EmpiricalEE/blues_note-hardware/Reference_Designs/SingleDryCell-LR6|AA/SingleDryCell_RevB.pdf

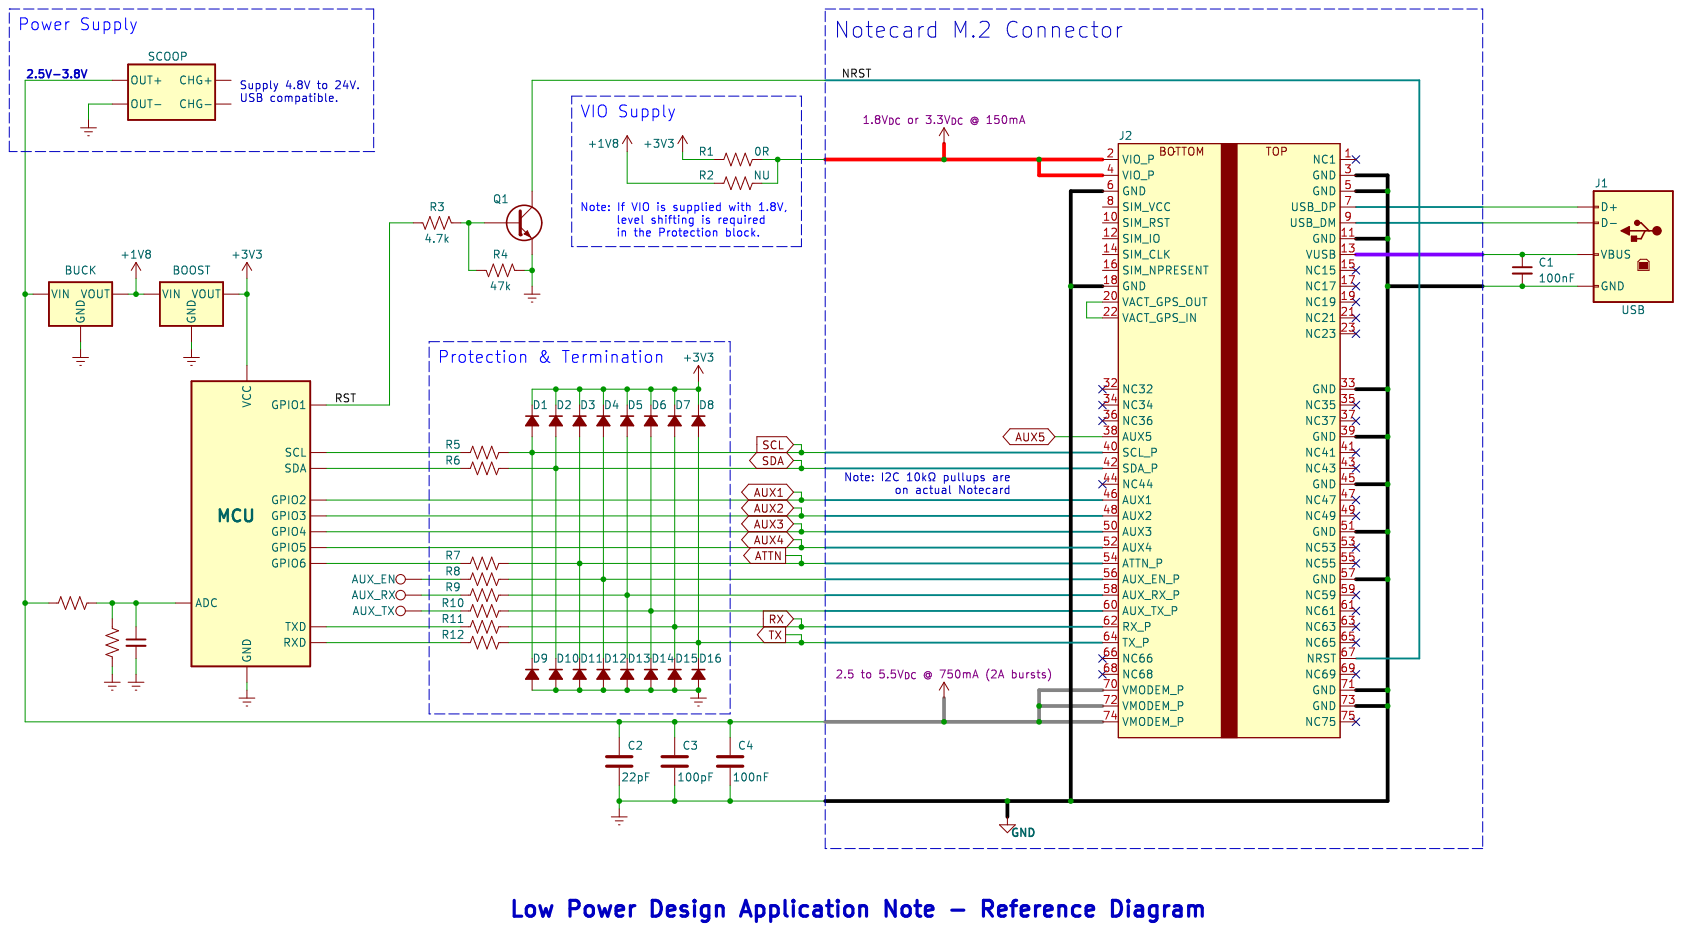
[picture p1: page 1]
