EmpiricalEE/blues_note-hardware/Reference_Designs/SingleDryCell-LR6|AA/SingleDryCell_RevA.pdf

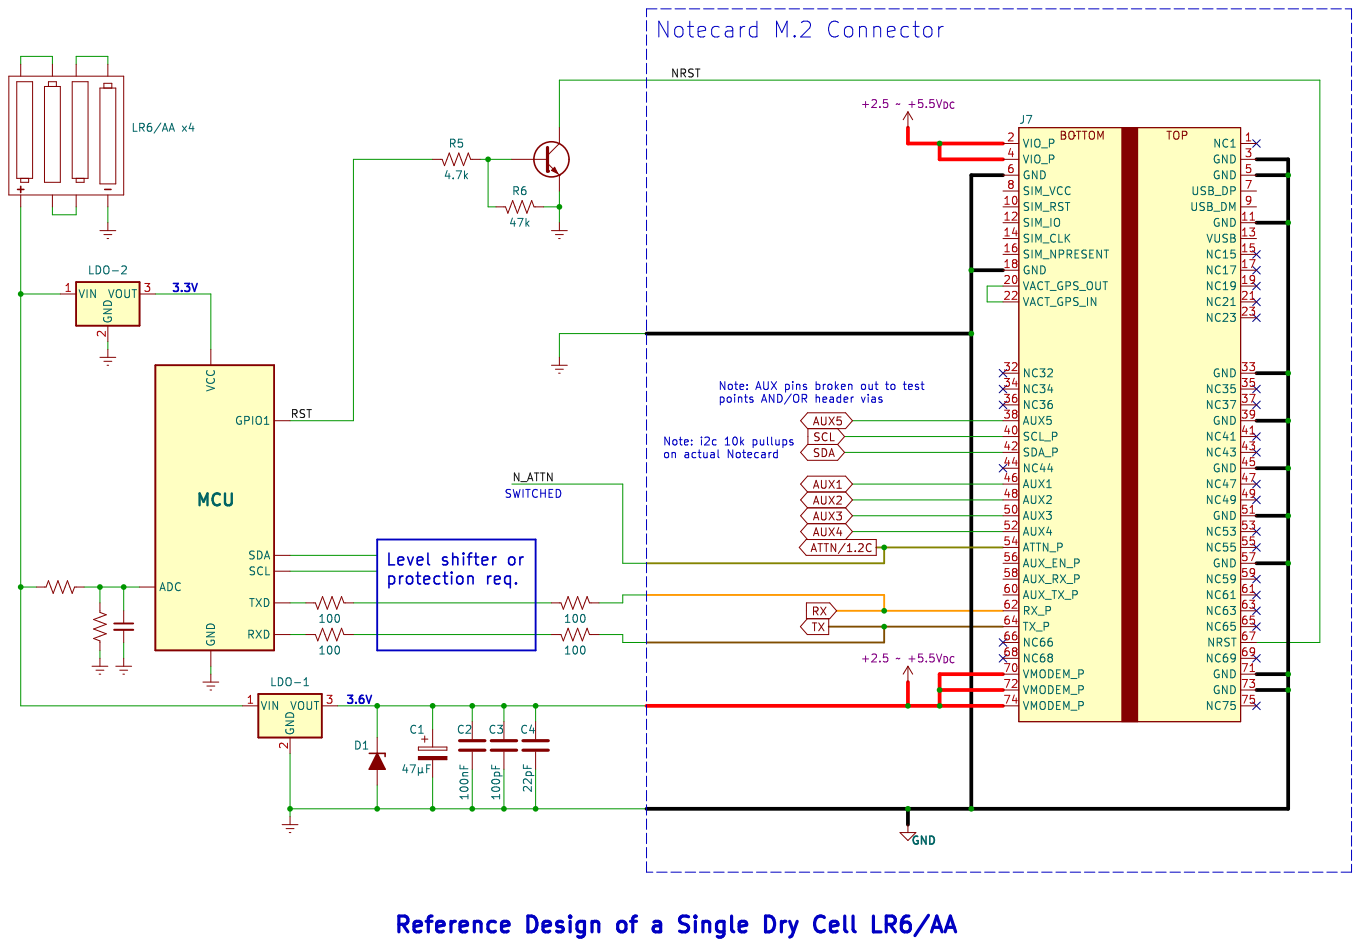
[picture p2: page 1]
