EmpiricalEE/blues_note-hardware/Notecarrier-B/KiCad_format/Notecarrier-B.kicad_sch

## KiCad design Notecarrier-B/KiCad_format/Notecarrier-B.kicad_sch (2023-07-28)

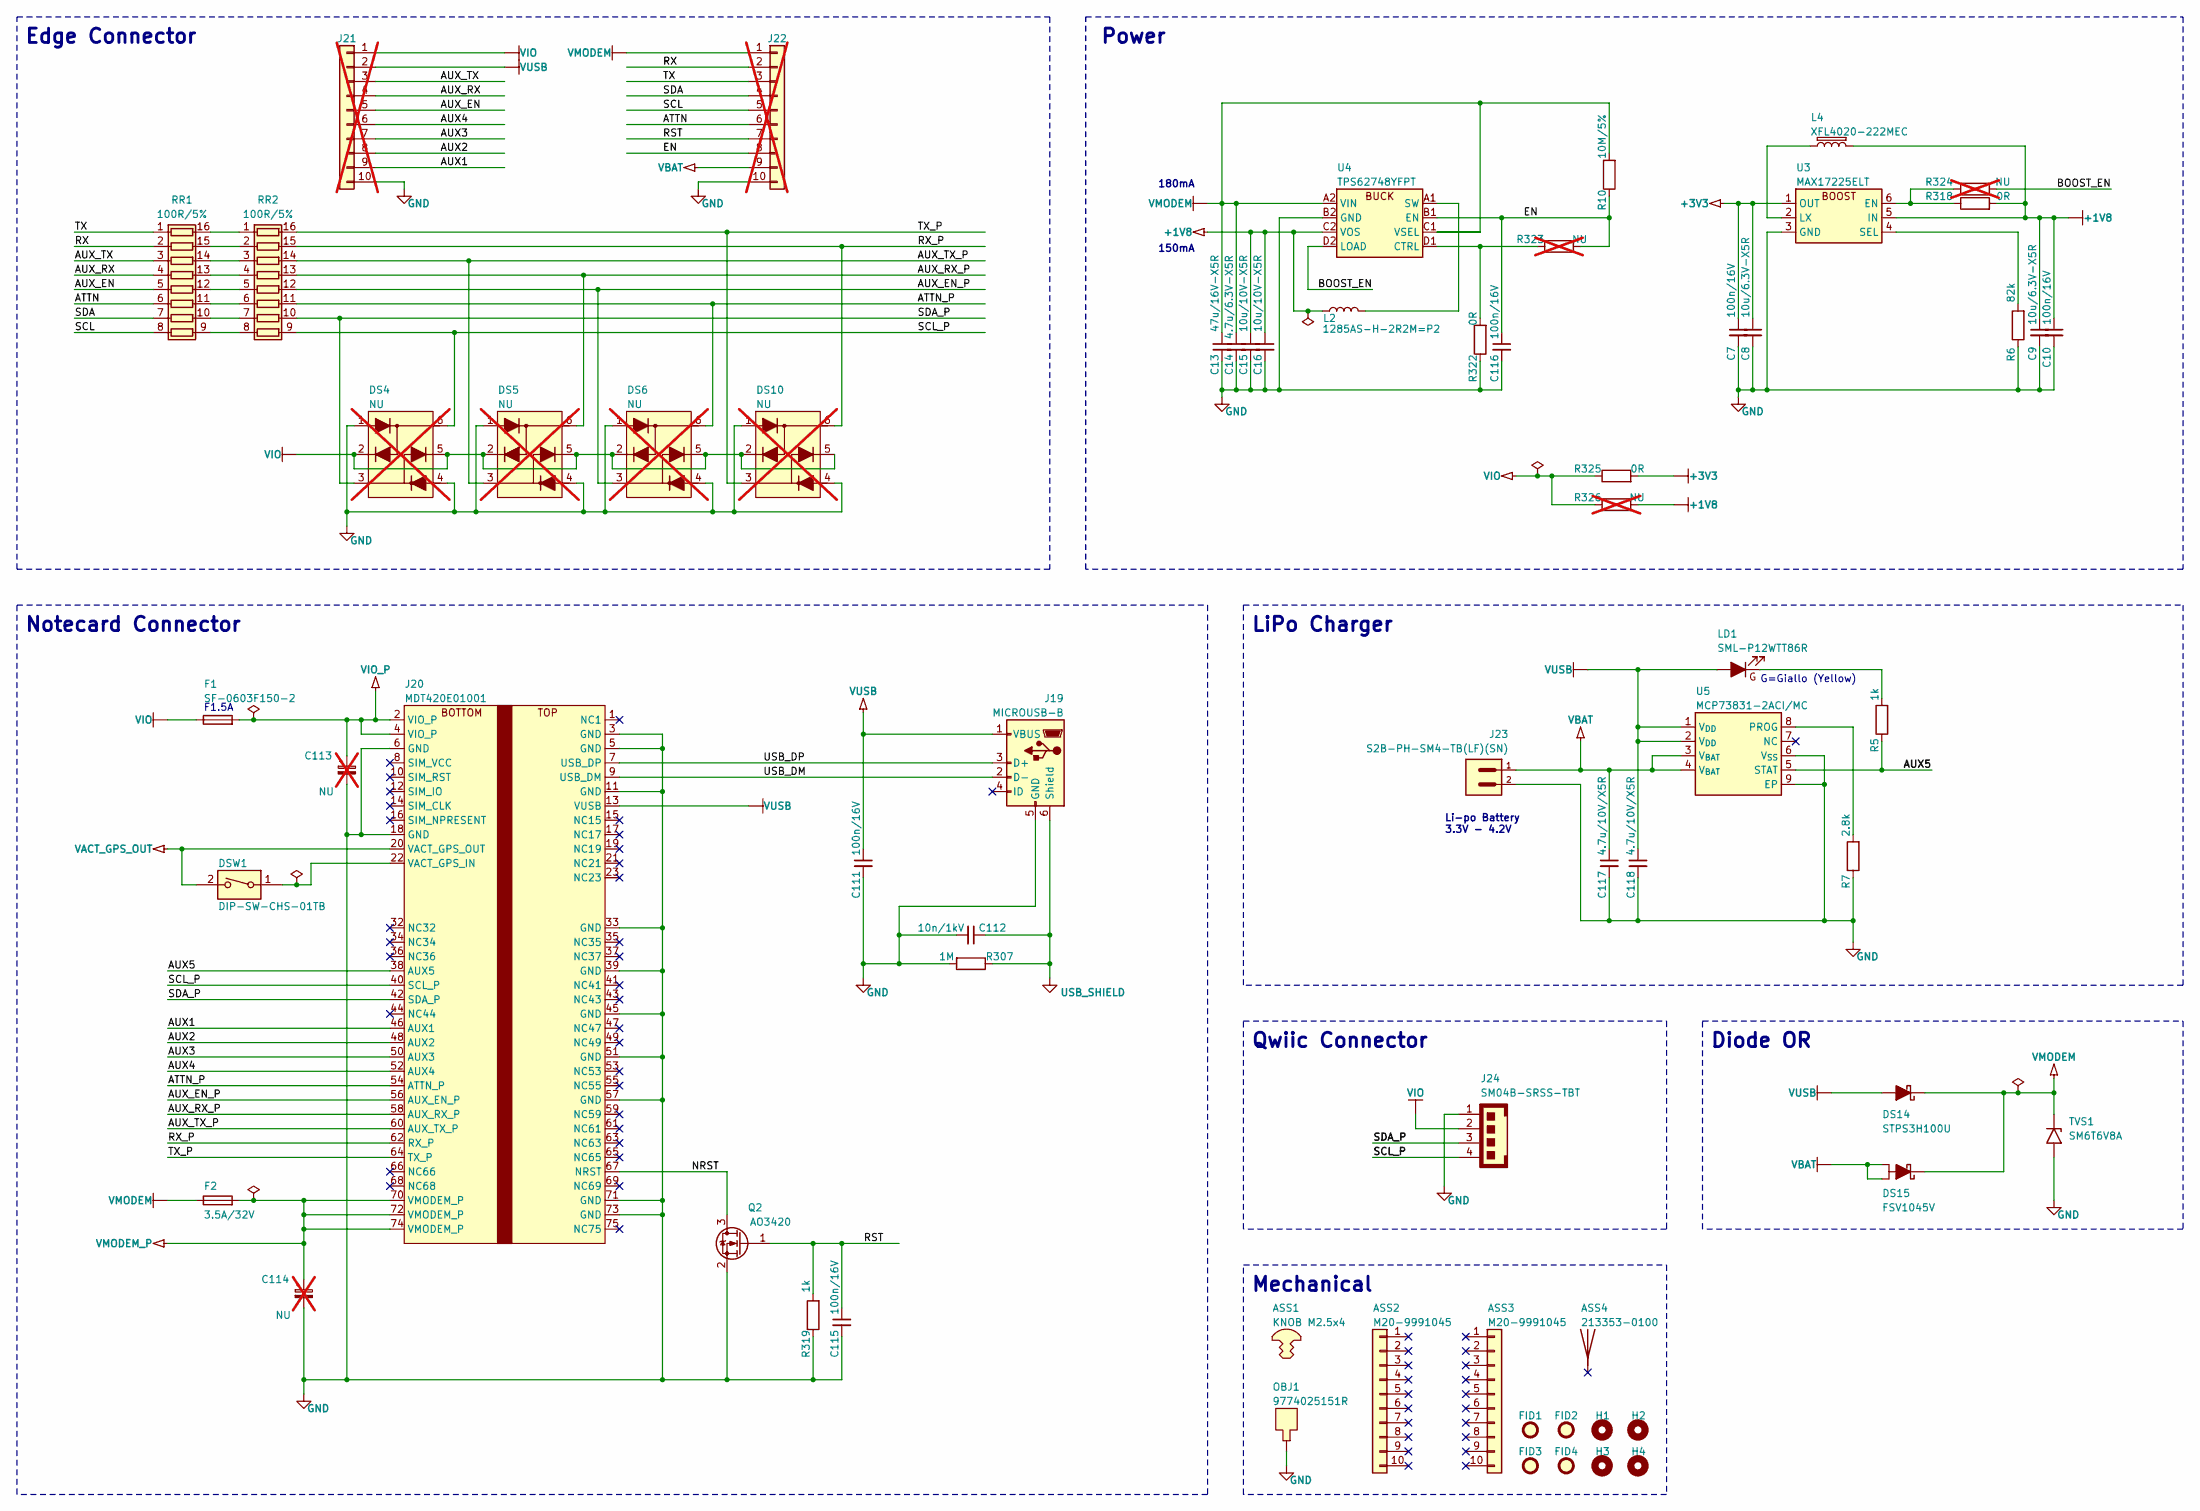
[picture p3: schematic Notecarrier-B.kicad_sch]

Parts:
ASS1: KNOB M2.5x4
ASS2, ASS3: M20-9991045; MPN M20-9991045
ASS4: 213353-0100; MPN 213353-0100
C7, C10, C111, C115, C116: 100n/16V; CS-C-0402_NO-FILL
C8, C9: 10u/6.3V-X5R; CS-C-0402_NO-FILL
C13: 47u/16V-X5R; CS-C-1206
C14: 4.7u/6.3V-X5R; CS-C-0402_NO-FILL
C15, C16: 10u/10V-X5R; CS-C-0603
C112: 10n/1kV; CS-C-1206
C113: NU; CS-T-A; MPN F930J107KAA; not fitted
C114: NU; CS-T-B; MPN F930J227KBA; not fitted
C117, C118: 4.7u/10V/X5R; CS-C-0603; MPN CL10A475KP8NNNC
DS4, DS5, DS6, DS10: NU; SOT563; MPN BAV99BRVA-7; not fitted
DS14: STPS3H100U; SMB; MPN STPS3H100U
DS15: FSV1045V; TO277-3; MPN FSV1045V
DSW1: DIP-SW-CHS-01TB; DSS-CHS-01TB
F1: SF-0603F150-2; FS-0603; MPN SF-0603F150-2
F2: 3.5A/32V; FS-0603; MPN 0603SFV350F/32-2
FID1, FID2, FID3, FID4: TPS; FIDUCIAL
H1, H2, H3, H4: MountingHole; FORO-0330-U
J19: MICROUSB-B; J-5-0065-FOS-MICROUSB10118192; MPN 10118192-0001LF
J20: MDT420E01001; J-75-0050-MOS-M2-E
J21, J22: NU; J-10-0254-MDT; MPN M20-9991045; not fitted
J23: S2B-PH-SM4-TB(LF)(SN); J-2-0200-MOS-S2B; MPN S2B-PH-SM4-TB(LF)(SN)
J24: SM04B-SRSS-TBT; J-4-0100-MOS-SH; MPN SM04B-SRSS-TBT(LF)(SN)
L2: 1285AS-H-2R2M=P2; LS-0806; MPN 1285AS-H-2R2M=P2
L4: XFL4020-222MEC; LS-XFL4020; MPN XFL4020-222MEC
LD1: SML-P12WTT86R; LD-0402; MPN SML-P12WTT86R
OBJ1: 9774025151R; DIST-WASMSIM0250
Q2: AO3420; SOT23_NO-FILL
R5: 1k; RS-0201_NO-FILL; MPN CRCW02011K00FNED
R6: 82k; RS-0402_NO-FILL
R7: 2.8k; RS-0201_NO-FILL; MPN CRCW02012K80FKED
R10: 10M/5%; RS-0402_NO-FILL
R307: 1M; RS-1206
R318, R322, R325: 0R; RS-0402_NO-FILL
R319: 1k; RS-0402_NO-FILL
R323, R324, R326: NU; RS-0402_NO-FILL; not fitted
RR1, RR2: 100R/5%; RR-8X-1506
TVS1: SM6T6V8A; SMB
U3: MAX17225ELT; WDFN6-0200X0200; MPN MAX17225ELT+T
U4: TPS62748YFPT; XFBGA8; MPN TPS62748YFPT
U5: MCP73831-2ACI/MC; VFDFN8-EXP; MPN MCP73831-2ACI/MC

Connections:
+1V8: C9.1, C10.1, C15.1, C16.1, L2.2, L4.2, R318.2, R326.2, U3.5 (IN), U4.C2 (VOS)
+3V3: C7.1, C8.1, R325.2, U3.1 (OUT)
ATTN: J22.6, RR1.6 (R6.1)
ATTN_P: DS6.6 (K1A2), J20.54 (ATTN_P), RR2.11 (R6.2)
AUX1: J20.46 (AUX1), J21.9
AUX2: J20.48 (AUX2), J21.8
AUX3: J20.50 (AUX3), J21.7
AUX4: J20.52 (AUX4), J21.6
AUX5: J20.38 (AUX5), R5.1, U5.5 (STAT)
AUX_EN: J21.5, RR1.5 (R5.1)
AUX_EN_P: DS6.3 (K3A4), J20.56 (AUX_EN_P), RR2.12 (R5.2)
AUX_RX: J21.4, RR1.4 (R4.1)
AUX_RX_P: DS5.6 (K1A2), J20.58 (AUX_RX_P), RR2.13 (R4.2)
AUX_TX: J21.3, RR1.3 (R3.1)
AUX_TX_P: DS5.3 (K3A4), J20.60 (AUX_TX_P), RR2.14 (R3.2)
BOOST_EN: R324.2, U4.D2 (LOAD)
EN: C116.1, J22.8, R10.1, R323.2, U4.B1 (EN)
GND: C7.2, C8.2, C9.2, C10.2, C13.2, C14.2, C15.2, C16.2, C111.2, C112.2, C113.2, C114.2, C115.2, C116.2, C117.2, C118.2, DS4.1 (A1), DS4.4 (A3), DS5.1 (A1), DS5.4 (A3), DS6.1 (A1), DS6.4 (A3), DS10.1 (A1), DS10.4 (A3), J19.5 (GND), J20.3 (GND), J20.5 (GND), J20.6 (GND), J20.11 (GND), J20.18 (GND), J20.33 (GND), J20.39 (GND), J20.45 (GND), J20.51 (GND), J20.57 (GND), J20.71 (GND), J20.73 (GND), J21.10, J22.10, J23.2, J24.1, OBJ1.1, Q2.2 (S), R6.1, R7.1, R307.2, R319.1, R322.1, TVS1.2 (A2), U3.3 (GND), U4.B2 (GND), U5.6 (V_{SS}), U5.9 (EP)
NRST: J20.67 (NRST), Q2.3 (D)
unnamed: DSW1.1, J20.22 (VACT_GPS_IN)
unnamed: L2.1, U4.A1 (SW)
unnamed: L4.1, U3.2 (LX)
unnamed: LD1.1 (K), R5.2
unnamed: R6.2, U3.4 (SEL)
unnamed: R7.2, U5.8 (PROG)
unnamed: R318.1, R324.1, U3.6 (EN)
unnamed: R322.2, R323.1, U4.D1 (CTRL)
unnamed: RR1.9 (R8.2), RR2.8 (R8.1)
unnamed: RR1.10 (R7.2), RR2.7 (R7.1)
unnamed: RR1.11 (R6.2), RR2.6 (R6.1)
unnamed: RR1.12 (R5.2), RR2.5 (R5.1)
unnamed: RR1.13 (R4.2), RR2.4 (R4.1)
unnamed: RR1.14 (R3.2), RR2.3 (R3.1)
unnamed: RR1.15 (R2.2), RR2.2 (R2.1)
unnamed: RR1.16 (R1.2), RR2.1 (R1.1)
RST: C115.1, J22.7, Q2.1 (G), R319.2
RX: J22.2, RR1.2 (R2.1)
RX_P: DS10.6 (K1A2), J20.62 (RX_P), RR2.15 (R2.2)
SCL: J22.5, RR1.8 (R8.1)
SCL_P: DS4.6 (K1A2), J20.40 (SCL_P), J24.4, RR2.9 (R8.2)
SDA: J22.4, RR1.7 (R7.1)
SDA_P: DS4.3 (K3A4), J20.42 (SDA_P), J24.3, RR2.10 (R7.2)
TX: J22.3, RR1.1 (R1.1)
TX_P: DS10.3 (K3A4), J20.64 (TX_P), RR2.16 (R1.2)
USB_DM: J19.2 (D-), J20.9 (USB_DM)
USB_DP: J19.3 (D+), J20.7 (USB_DP)
USB_SHIELD: C112.1, J19.6 (Shield), R307.1
VACT_GPS_OUT: DSW1.2, J20.20 (VACT_GPS_OUT)
VBAT: C117.1, DS15.1 (A1), DS15.2 (A2), J22.9, J23.1, U5.3 (V_{BAT}), U5.4 (V_{BAT})
VIO: DS4.2 (K2), DS4.5 (K4), DS5.2 (K2), DS5.5 (K4), DS6.2 (K2), DS6.5 (K4), DS10.2 (K2), DS10.5 (K4), F1.1, J21.1, J24.2, R325.1, R326.1
VIO_P: C113.1, F1.2, J20.2 (VIO_P), J20.4 (VIO_P)
VMODEM: C13.1, C14.1, DS14.1 (K), DS15.3 (C), F2.1, J22.1, R10.2, TVS1.1 (A1), U4.A2 (VIN), U4.C1 (VSEL)
VMODEM_P: C114.1, F2.2, J20.70 (VMODEM_P), J20.72 (VMODEM_P), J20.74 (VMODEM_P)
VUSB: C111.1, C118.1, DS14.2 (A), J19.1 (VBUS), J20.13 (VUSB), J21.2, LD1.2 (A), U5.1 (V_{DD}), U5.2 (V_{DD})

Notes on the sheet:
LiPo Charger
Mechanical
G=Giallo (Yellow)
Qwiic Connector
150mA
180mA
Li-po Battery 3.3V - 4.2V
F1.5A
Edge Connector
Notecard Connector
Power
Diode OR
