EmpiricalEE/blues_note-hardware/Reference_Designs/SingleDryCell-LR6|AA/SingleDryCell.kicad_sch

## KiCad design Reference_Designs/SingleDryCell-LR6|AA/SingleDryCell.kicad_sch (2023-08-22)

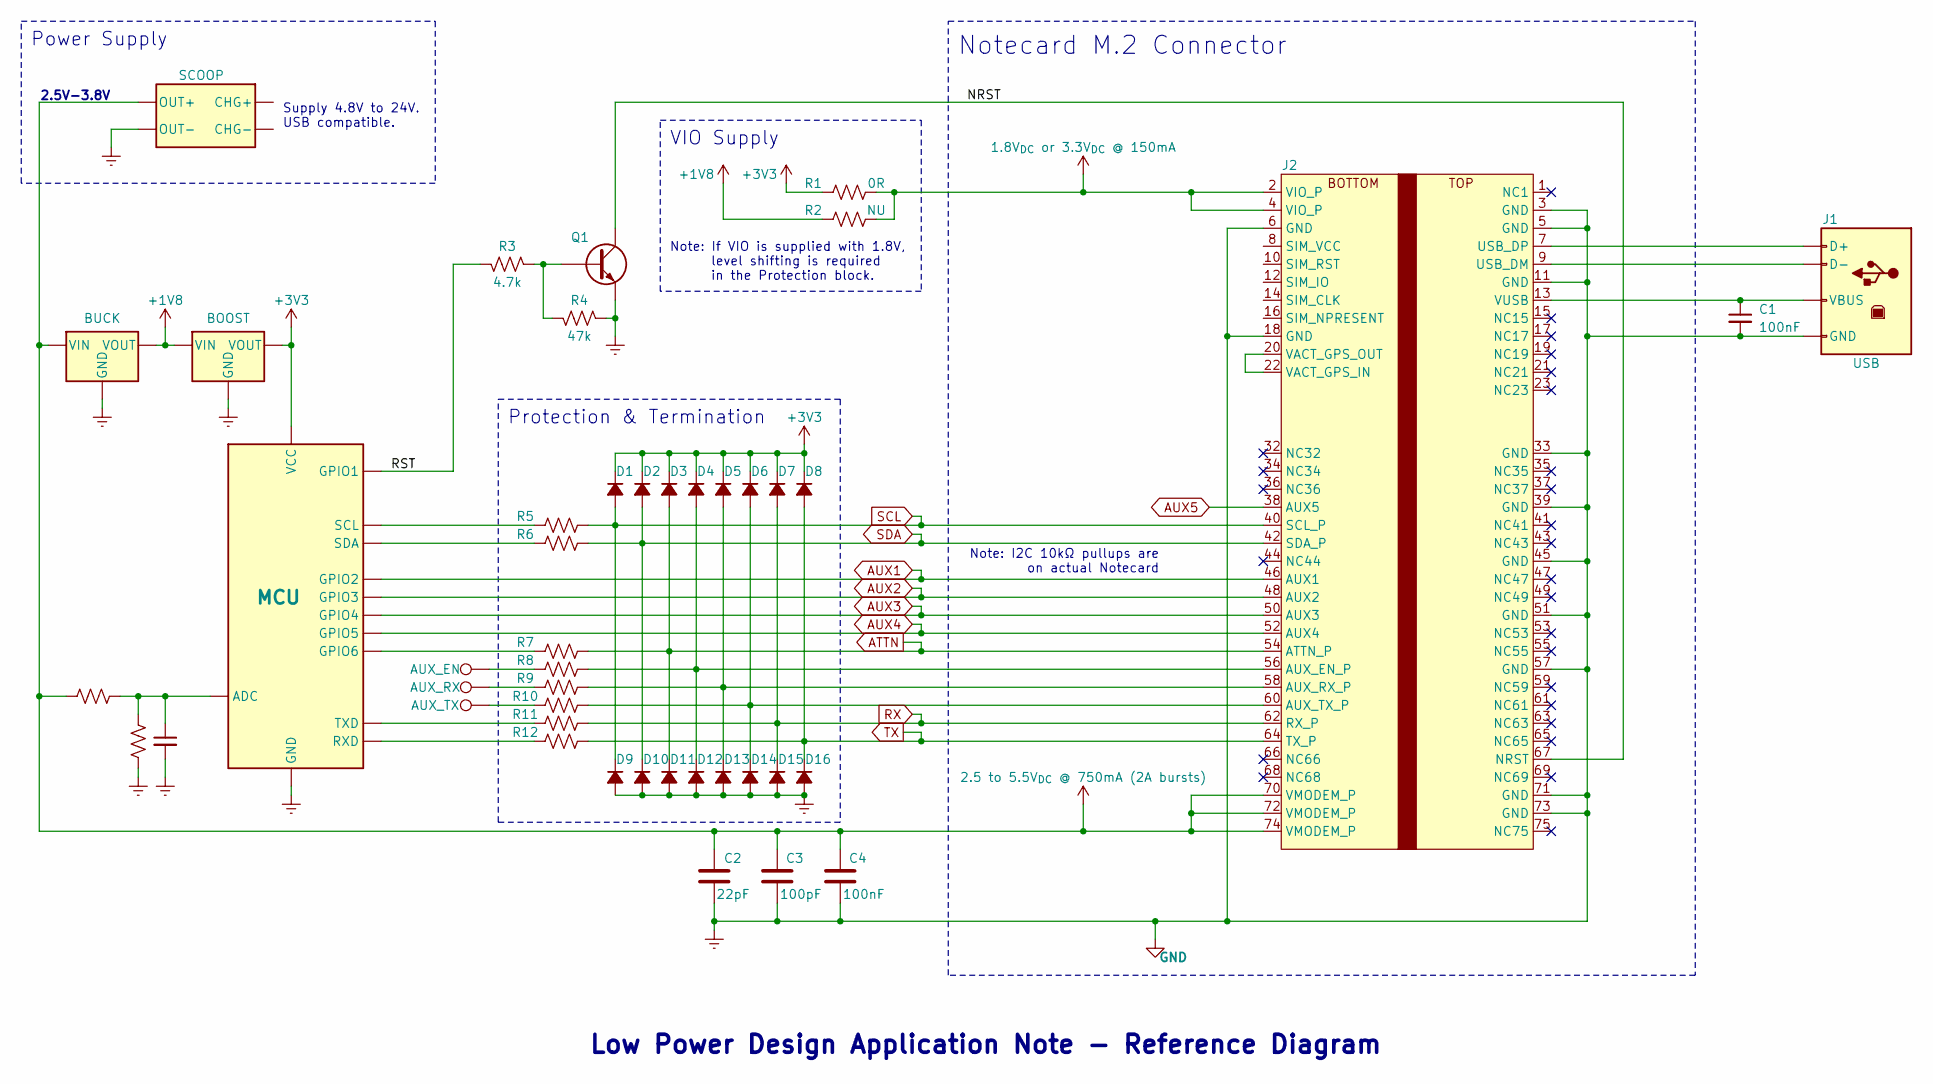
[picture p4: schematic SingleDryCell.kicad_sch]

Parts:
BOOST: (no value)
BUCK: (no value)
C1, C4: 100nF
C2: 22pF
C3: 100pF
D1, D2, D3, D4, D5, D6, D7, D8, D9, D10, D11, D12, D13, D14, D15, D16: D_Small_Filled
J1: USB
J2: MDT420E01001; J-75-0050-MOS-M2-E
MCU: (no value)
Q1: Q_NPN_BCE
R1: 0R
R2: NU
R3: 4.7k
R4: 47k
R5, R6, R7, R8, R9, R11, R12: 200
R10, R13: 100
SCOOP: (no value)
TP1: AUX_EN
TP2: AUX_RX
TP3: AUX_TX

Connections:
+1V8: BOOST.1 (VIN), BUCK.3 (VOUT), R2.1
+3V3: BOOST.3 (VOUT), D1.1 (K), D2.1 (K), D3.1 (K), D4.1 (K), D5.1 (K), D6.1 (K), D7.1 (K), D8.1 (K), MCU.2 (VCC), R1.1
+BATT: BUCK.1 (VIN), C2.1, C3.1, C4.1, J2.70 (VMODEM_P), J2.72 (VMODEM_P), J2.74 (VMODEM_P), R10.1, SCOOP.3 (OUT+)
ATTN: D3.2 (A), D11.1 (K), J2.54 (ATTN_P), R7.2
AUX1: J2.46 (AUX1), MCU.23 (GPIO2)
AUX2: J2.48 (AUX2), MCU.22 (GPIO3)
AUX3: J2.50 (AUX3), MCU.21 (GPIO4)
AUX4: J2.52 (AUX4), MCU.20 (GPIO5)
AUX5: J2.38 (AUX5)
Earth: BOOST.2 (GND), BUCK.2 (GND), C1.2, C2.2, C3.2, C4.2, D9.2 (A), D10.2 (A), D11.2 (A), D12.2 (A), D13.2 (A), D14.2 (A), D15.2 (A), D16.2 (A), J1.4 (GND), J2.3 (GND), J2.5 (GND), J2.6 (GND), J2.11 (GND), J2.18 (GND), J2.33 (GND), J2.39 (GND), J2.45 (GND), J2.51 (GND), J2.57 (GND), J2.71 (GND), J2.73 (GND), MCU.4 (GND), Q1.3 (E), R4.2, R13.1, SCOOP.3 (OUT+)
NRST: J2.67 (NRST), Q1.2 (C)
unnamed: C1.1, J1.1 (VBUS), J2.13 (VUSB)
unnamed: C2.1, MCU.5 (ADC), R10.2, R13.2
unnamed: D4.2 (A), D12.1 (K), J2.56 (AUX_EN_P), R8.2
unnamed: D5.2 (A), D13.1 (K), J2.58 (AUX_RX_P), R9.2
unnamed: D6.2 (A), D14.1 (K), J2.60 (AUX_TX_P), R10.2
unnamed: J1.2 (D-), J2.9 (USB_DM)
unnamed: J1.3 (D+), J2.7 (USB_DP)
unnamed: J2.20 (VACT_GPS_OUT), J2.22 (VACT_GPS_IN)
unnamed: MCU.14 (TXD), R11.1
unnamed: MCU.15 (RXD), R12.1
unnamed: MCU.17 (SDA), R6.1
unnamed: MCU.18 (SCL), R5.1
unnamed: MCU.19 (GPIO6), R7.1
unnamed: Q1.1 (B), R3.2, R4.1
unnamed: R8.1, TP1.1
unnamed: R9.1, TP2.1
unnamed: R10.1, TP3.1
RST: MCU.6 (GPIO1), R3.1
RX: D7.2 (A), D15.1 (K), J2.62 (RX_P), R11.2
SCL: D1.2 (A), D9.1 (K), J2.40 (SCL_P), R5.2
SDA: D2.2 (A), D10.1 (K), J2.42 (SDA_P), R6.2
TX: D8.2 (A), D16.1 (K), J2.64 (TX_P), R12.2
VCC: J2.2 (VIO_P), J2.4 (VIO_P), R1.2, R2.2

Notes on the sheet:
Protection & Termination
Supply 4.8V to 24V. USB compatible.
Note: I2C 10kΩ pullups are on actual Notecard
Note: If VIO is supplied with 1.8V, level shifting is required in the Protection block.
Low Power Design Application Note - Reference Diagram
Power Supply
2.5V-3.8V
Notecard M.2 Connector
VIO Supply
