EmpiricalEE/blues_note-hardware/(commit log)

2023-07-28 Corrected M.2 connector pin 38 name “NC38” —> “AUX5”.
    No functional change, no up-rev. Root change made in library and imported into this project to match original schematics. See blues-kicad-lib log for details on where this change does and does not apply.
    [Notecarrier-B.kicad_sch]
2023-07-28 Add first draft of Single Dry Cell reference schematic.
    [SingleDryCell.kicad_sch]
2023-07-31 Release Rev A of Single Dry Cell reference design.
    [SingleDryCell.kicad_sch]
2023-08-22 Release Rev B of reference design.
    [SingleDryCell.kicad_sch]
